retrocityransom/SNES-to-NeoGeo-EX/files/3d_printing_files/Snes2Neo_bottom.stl

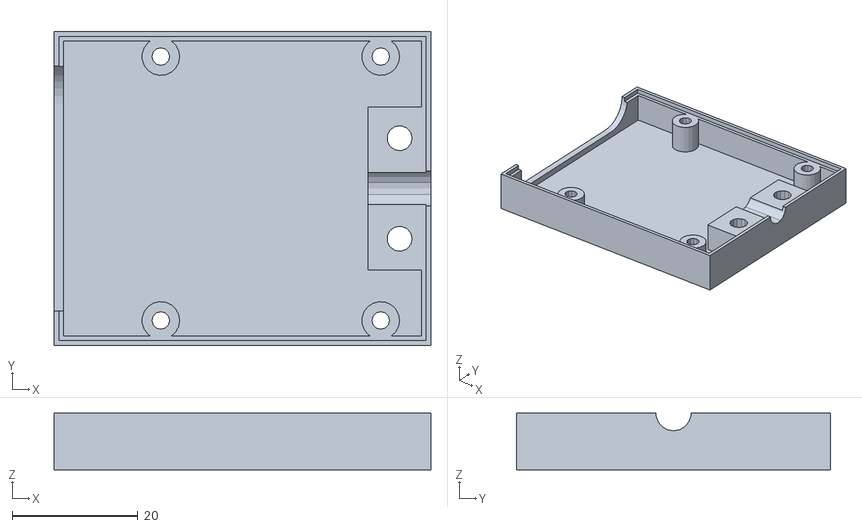
[picture p23: CAD file, 2026-06-21]
files/3d_printing_files/Snes2Neo_bottom.stl
60.0 x 50.0 x 9.00
