retrocityransom/SNES-to-NeoGeo-EX/files/3d_printing_files/Snes2Neo_logo.stl

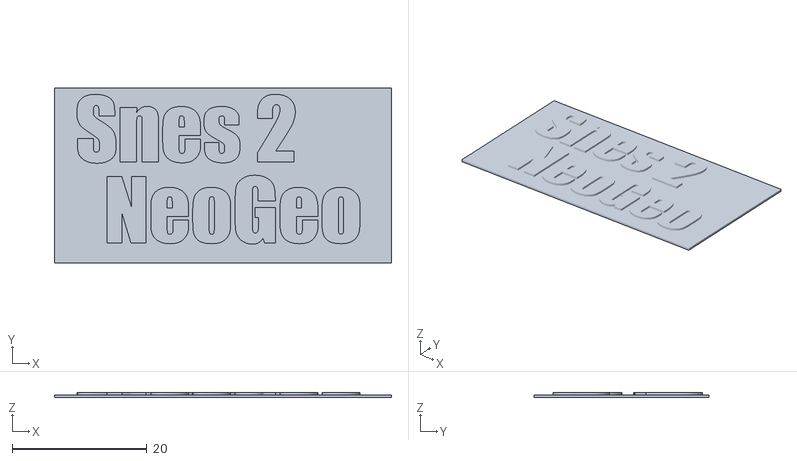
[picture p24: CAD file, 2026-06-21]
files/3d_printing_files/Snes2Neo_logo.stl
50.0 x 26.0 x 0.8
