retrocityransom/SNES-to-NeoGeo-EX/files/3d_printing_files/Snes2Neo_top.stl

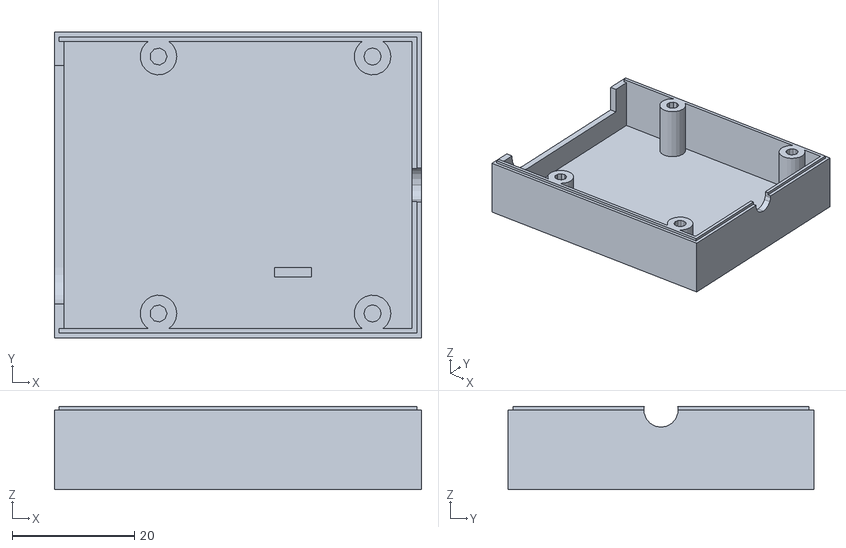
[picture p25: CAD file, 2026-06-21]
files/3d_printing_files/Snes2Neo_top.stl
60.0 x 50.0 x 13.6
