retrocityransom/SNES-to-NeoGeo-EX/(list of files, cad)

Other CAD files:
files/3d_printing_files/Snes2Neo_bottom.scad
files/3d_printing_files/Snes2Neo_logo.scad
files/3d_printing_files/Snes2Neo_top.scad
